quaint-systems/coax-tcp/interface3/pcb/pcb.kicad_pcb

## KiCad design interface3/pcb/pcb.kicad_pcb (2026-09-26)

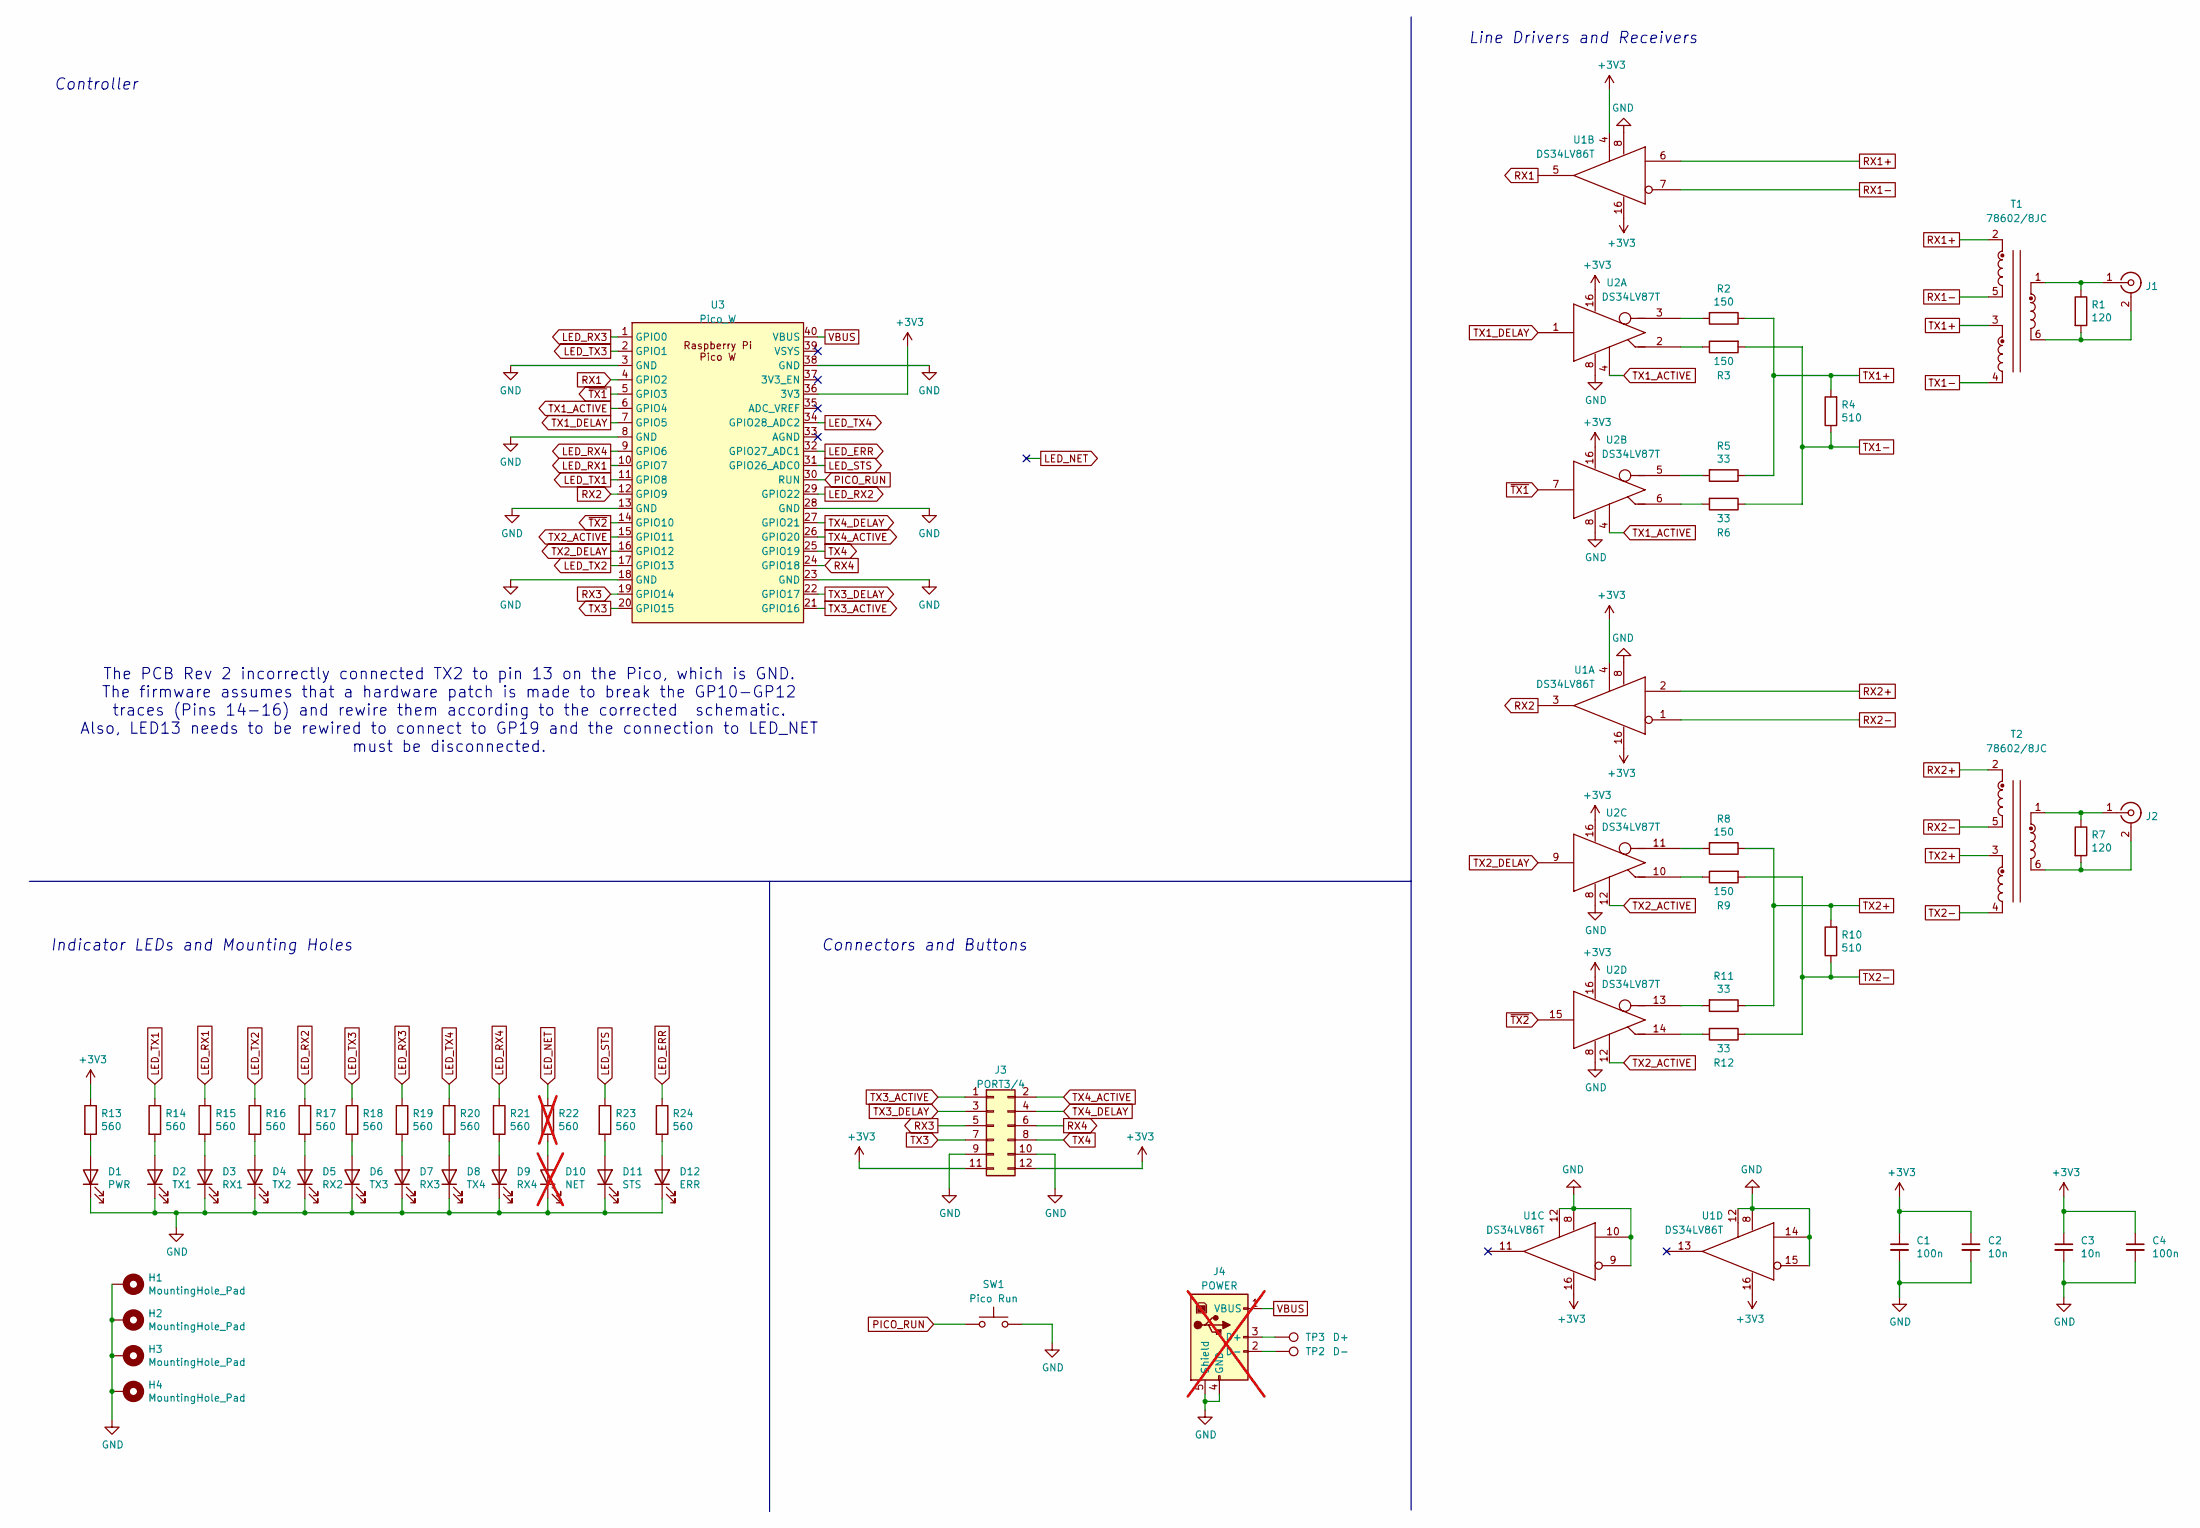
[picture p1: schematic pcb.kicad_sch, Liz 4174 Terminal Controller]

Parts:
C1, C4: 100n; C_0603_1608Metric_Pad1.08x0.95mm_HandSolder; Part EMK107B7104KA-T
C2, C3: 10n; C_0603_1608Metric_Pad1.08x0.95mm_HandSolder; Part HMK107B7103KA-T
D1: PWR; LED_0603_1608Metric; Part 150060YS55040
D2: TX1; LED_0603_1608Metric; Part 150060YS55040
D3: RX1; LED_0603_1608Metric; Part 150060YS55040
D4: TX2; LED_0603_1608Metric; Part 150060YS55040
D5: RX2; LED_0603_1608Metric; Part 150060YS55040
D6: TX3; LED_0603_1608Metric; Part 150060YS55040
D7: RX3; LED_0603_1608Metric; Part 150060YS55040
D8: TX4; LED_0603_1608Metric; Part 150060YS55040
D9: RX4; LED_0603_1608Metric; Part 150060YS55040
D10: NET; LED_0603_1608Metric; Part 150060RS55040; not fitted
D11: STS; LED_0603_1608Metric; Part 150060RS55040
D12: ERR; LED_0603_1608Metric; Part 150060RS55040
H1, H2, H3, H4: MountingHole_Pad; MountingHole_2.7mm_M2.5_ISO7380_Pad
J1: PORT1; BNC_Amphenol_B6252HB-NPP3G-50_Horizontal; Part 1-1337543-0
J2: PORT2; BNC_Amphenol_B6252HB-NPP3G-50_Horizontal; Part 1-1337543-0
J3: PORT3/4; PinHeader_2x06_P2.54mm_Vertical
J4: POWER; USB_B_OST_USB-B1HSxx_Horizontal; not fitted
R1, R7: 120; R_0603_1608Metric_Pad0.98x0.95mm_HandSolder; Part RCS0603120RFKEA
R2, R3, R8, R9: 150; R_0603_1608Metric_Pad0.98x0.95mm_HandSolder; Part RCS0603150RFKEA
R4, R10: 510; R_0603_1608Metric_Pad0.98x0.95mm_HandSolder; Part RCS0603510RFKEA
R5, R6, R11, R12: 33; R_0603_1608Metric_Pad0.98x0.95mm_HandSolder; Part RCS060333R0FKEA
R13, R14, R15, R16, R17, R18, R19, R20, R21, R23, R24: 560; R_0603_1608Metric_Pad0.98x0.95mm_HandSolder; Part RCS0603560RFKEA
R22: 560; R_0603_1608Metric_Pad0.98x0.95mm_HandSolder; Part RCS0603560RFKEA; not fitted
SW1: Pico Run; SW_Push_1P1T_NO_6x6mm_H9.5mm
T1, T2: 78602/8JC; Murata_786J; Part 78602/8JC
TP2: D-; TestPoint_Pad_D2.0mm
TP3: D+; TestPoint_Pad_D2.0mm
U1: DS34LV86T; SOIC-16_3.9x9.9mm_P1.27mm; Part DS34LV86T
U2: DS34LV87T; SOIC-16_3.9x9.9mm_P1.27mm; Part DS34LV87T
U3: Pico_W; RPi_Pico_W_SMD_TH

Connections:
+3V3: C1.1, C2.1, C3.1, C4.1, J3.11, J3.12, R13.1, U1.4 (ENABLE), U1.16 (VCC), U2.16 (VCC), U3.36 (3V3)
GND: C1.2, C2.2, C3.2, C4.2, D1.1 (K), D2.1 (K), D3.1 (K), D4.1 (K), D5.1 (K), D6.1 (K), D7.1 (K), D8.1 (K), D9.1 (K), D10.1 (K), D11.1 (K), D12.1 (K), H1.1 (1_1), H2.1 (1_1), H3.1 (1_1), H4.1 (1_1), J3.9, J3.10, J4.4 (GND), J4.5 (Shield), SW1.2, U1.8 (GND), U1.9 (E-), U1.10 (E+), U1.12 (ENABLE), U1.14 (E+), U1.15 (E-), U2.8 (GND), U3.3 (GND), U3.8 (GND), U3.13 (GND), U3.18 (GND), U3.23 (GND), U3.28 (GND), U3.38 (GND)
LED_ERR: R24.1, U3.32 (GPIO27_ADC1)
LED_NET: R22.1
LED_RX1: R15.1, U3.10 (GPIO7)
LED_RX2: R17.1, U3.29 (GPIO22)
LED_RX3: R19.1, U3.1 (GPIO0)
LED_RX4: R21.1, U3.9 (GPIO6)
LED_STS: R23.1, U3.31 (GPIO26_ADC0)
LED_TX1: R14.1, U3.11 (GPIO8)
LED_TX2: R16.1, U3.17 (GPIO13)
LED_TX3: R18.1, U3.2 (GPIO1)
LED_TX4: R20.1, U3.34 (GPIO28_ADC2)
unnamed: D1.2 (A), R13.2
unnamed: D2.2 (A), R14.2
unnamed: D3.2 (A), R15.2
unnamed: D4.2 (A), R16.2
unnamed: D5.2 (A), R17.2
unnamed: D6.2 (A), R18.2
unnamed: D7.2 (A), R19.2
unnamed: D8.2 (A), R20.2
unnamed: D9.2 (A), R21.2
unnamed: D10.2 (A), R22.2
unnamed: D11.2 (A), R23.2
unnamed: D12.2 (A), R24.2
unnamed: J1.2 (Ext), R1.2, T1.6
unnamed: J1.1 (In), R1.1, T1.1
unnamed: J2.2 (Ext), R7.2, T2.6
unnamed: J2.1 (In), R7.1, T2.1
unnamed: J4.3 (D+), TP3.1 (1_1)
unnamed: J4.2 (D-), TP2.1 (1_1)
unnamed: R3.1, U2.2 (OUT+)
unnamed: R2.2, U2.3 (OUT-)
unnamed: R6.2, U2.6 (OUT+)
unnamed: R5.2, U2.5 (OUT-)
unnamed: R9.1, U2.10 (OUT+)
unnamed: R8.2, U2.11 (OUT-)
unnamed: R12.2, U2.14 (OUT+)
unnamed: R11.2, U2.13 (OUT-)
PICO_RUN: SW1.1, U3.30 (RUN)
RX1: U1.5 (OUT), U3.4 (GPIO2)
RX1+: T1.2, U1.6 (E+)
RX1-: T1.5, U1.7 (E-)
RX2: U1.3 (OUT), U3.12 (GPIO9)
RX2+: T2.2, U1.2 (E+)
RX2-: T2.5, U1.1 (E-)
RX3: J3.5, U3.19 (GPIO14)
RX4: J3.6, U3.24 (GPIO18)
TX1+: R2.1, R4.2, R5.1, T1.3
TX1-: R3.2, R4.1, R6.1, T1.4
TX1_ACTIVE: U2.4 (ENABLE), U3.6 (GPIO4)
TX1_DELAY: U2.1 (INPUT), U3.7 (GPIO5)
TX2+: R8.1, R10.2, R11.1, T2.3
TX2-: R9.2, R10.1, R12.1, T2.4
TX2_ACTIVE: U2.12 (ENABLE), U3.15 (GPIO11)
TX2_DELAY: U2.9 (INPUT), U3.16 (GPIO12)
TX3: J3.7, U3.20 (GPIO15)
TX3_ACTIVE: J3.1, U3.21 (GPIO16)
TX3_DELAY: J3.3, U3.22 (GPIO17)
TX4: J3.8, U3.25 (GPIO19)
TX4_ACTIVE: J3.2, U3.26 (GPIO20)
TX4_DELAY: J3.4, U3.27 (GPIO21)
VBUS: J4.1 (VBUS), U3.40 (VBUS)
~TX1: U2.7 (INPUT), U3.5 (GPIO3)
~TX2: U2.15 (INPUT), U3.14 (GPIO10)

Notes on the sheet:
Connectors and Buttons
Line Drivers and Receivers
Controller
The PCB Rev 2 incorrectly connected TX2 to pin 13 on the Pico, which is GND. The firmware assumes that a hardware patch is made to break the GP10-GP12 traces (Pins 14-16) and rewire them according to the corrected schematic. Also, LED13 needs to be rewired to connect to GP19 and the connection to L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
Indicator LEDs and Mounting Holes

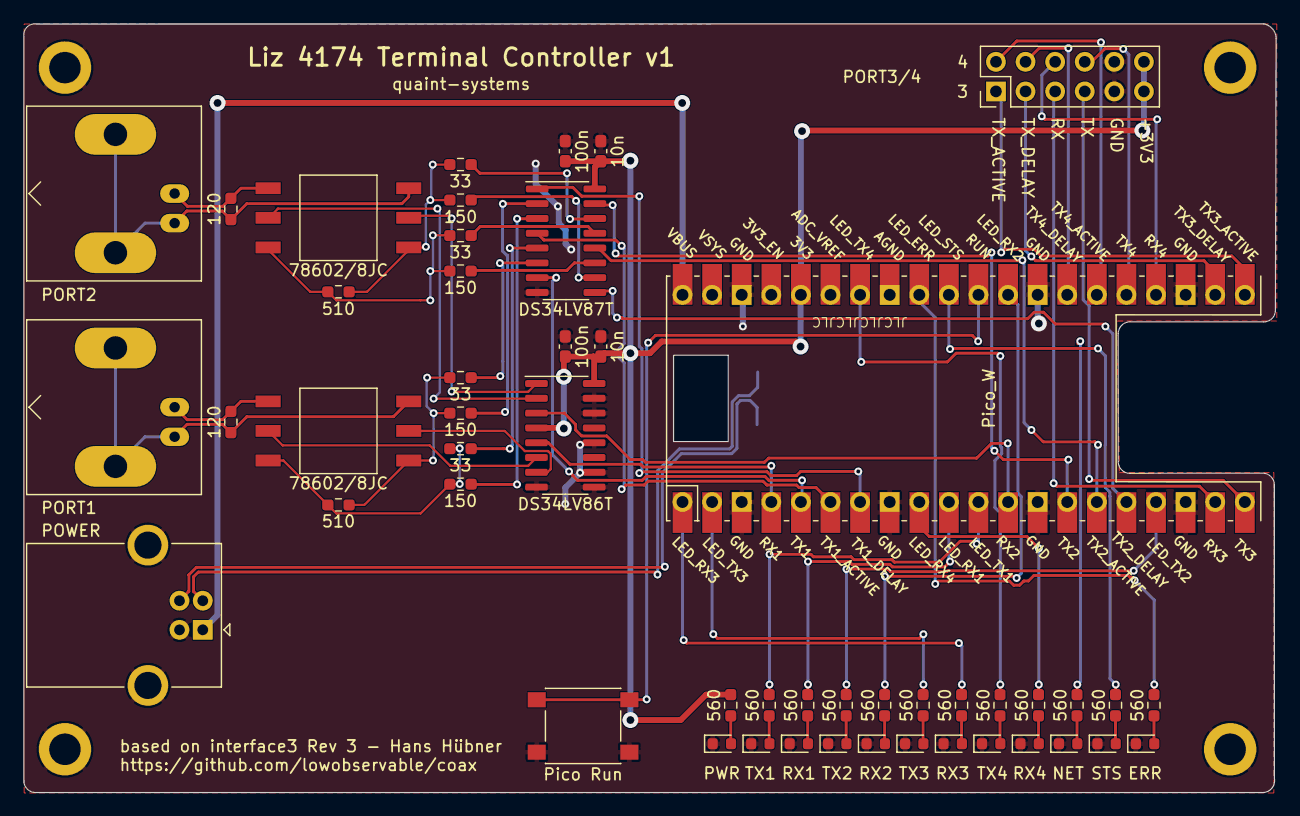
[picture p2: board pcb.kicad_pcb from above]

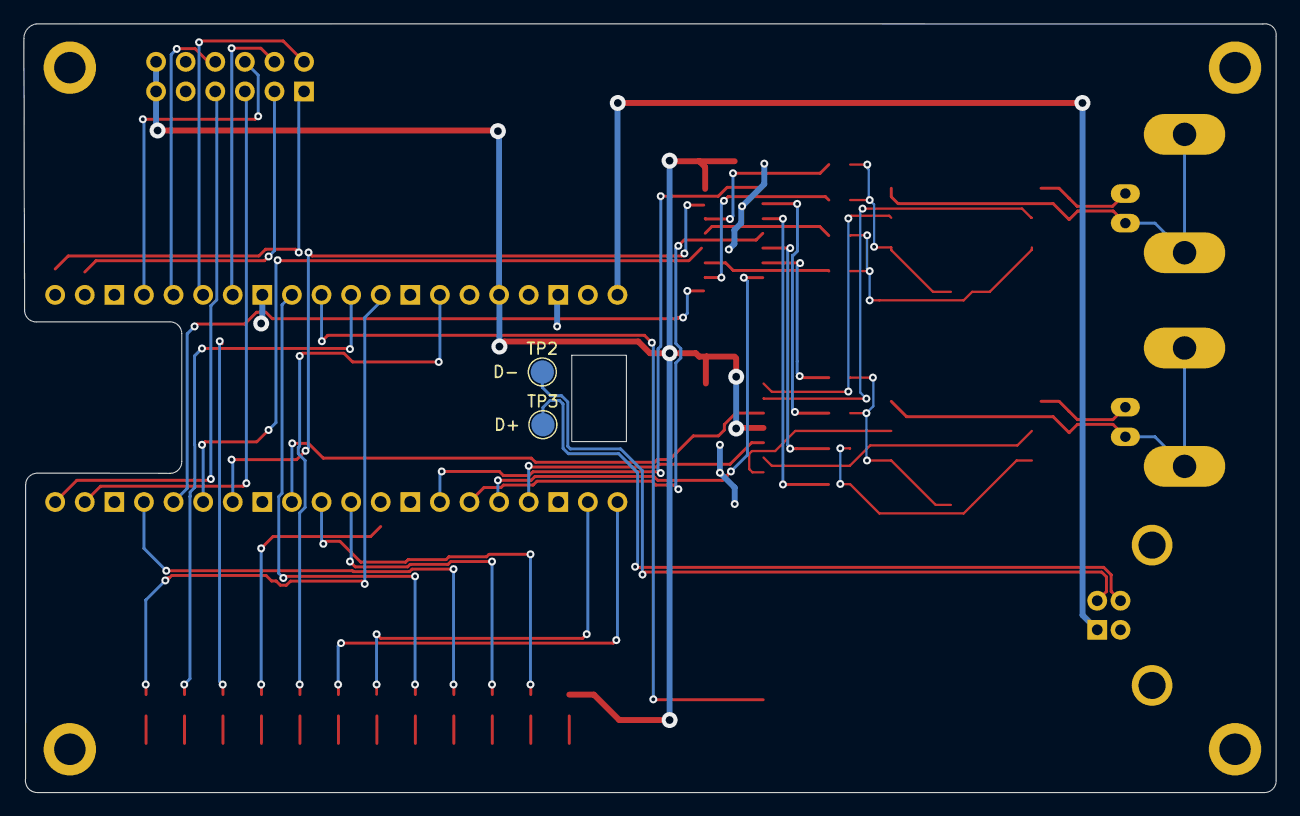
[picture p3: board pcb.kicad_pcb from below]

Board: 2 copper layers, 107.5 x 66.0 mm, 56 parts (2 on the bottom side), 64 nets.
