quaint-systems/coax-tcp/(commit log)

2026-09-26 Correct the Pico pin labels and parts data the second-port reroute left stale
    Pad 19 carries RX3 but was labelled TX3, and pad 29 drives LED_RX2 since the
    reroute but was still labelled LED_NET. The NET LED and its resistor no
    longer have a driver, so they are marked do not place. C3 and C4 carried each
    other's part numbers. The Run button's 3D model pointed at a library entry
    KiCad no longer ships and rendered off its pads, so it now names the model
    KiCad resolves to and centres it. KiCad's lock files and local history stay
    out of git.
    [pcb.kicad_pcb, pcb.kicad_sch]
2026-09-26 Brand the board as the Liz 4174 Terminal Controller v1 with a socketed Pico
    The silkscreen names the board and credits interface3 Rev 3 and Hans Hübner,
    and the title blocks follow. The Pico now sits in a pair of 1x20 sockets and
    is supplied separately, so it is left out of the BOM and the placement file.
    A socketed Pico cannot reach the USB-B jack's data pads under it, and the jack
    would tie two hosts' VBUS together through the Pico's own port, so J4 is
    marked do not place and the Pico's micro-USB carries power and data.
    [pcb.kicad_pcb, pcb.kicad_sch]
2026-09-26 Fit a yellow PWR LED so every LED on the board is a JLC Basic or Preferred part
    JLC no longer carries a green 0603 LED outside its Extended library, which
    charges a setup fee per part. The PWR LED now takes the same yellow part as
    the TX and RX LEDs.
    [pcb.kicad_pcb, pcb.kicad_sch]
2026-09-26 Add the JLCPCB fabrication and assembly files for the Liz 4174 board
    parts.csv accounts for every footprint on the board, with its LCSC part and
    whether JLC places it, hand-solders it, or leaves it off. make_jlc.py
    regenerates the Gerbers, drill files, BOM and placement file from the board
    and that list, and stops if the two disagree. The README records the order
    options and the parts that need attention: U2's thin stock, the transformers
    LCSC does not carry, and the placement preview checks.
    [liz4174-v1-bom.csv, parts.csv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]
2026-09-26 Note that the yellow LED is an Extended part at JLC, not a Preferred one
    [parts.csv]
2026-09-26 Leave the drill maps and the job file out of the Gerber zip
    With them in the zip, JLC's uploader quoted the 2-layer board as 6 layers,
    which also priced in an engineering fee, a longer build and Standard-only
    assembly. The zip now holds the nine layers and the two Excellon files.
2026-09-26 Record the Extended-part fees the Economic quote actually charged
    [parts.csv]
2026-09-26 Rotate the SOIC-16s by 270 degrees for JLC's placement
    JLC's library holds the SOIC-16 lying down with pin 1 at the bottom left, so KiCad's 0 degrees placed U1 and U2 across their pad columns in the preview.
    [liz4174-v1-cpl.csv]
